acornitum/hemlock/stopwatch-point-3.kicad_pcb

## KiCad design stopwatch-point-3.kicad_pcb (2026-10-15)

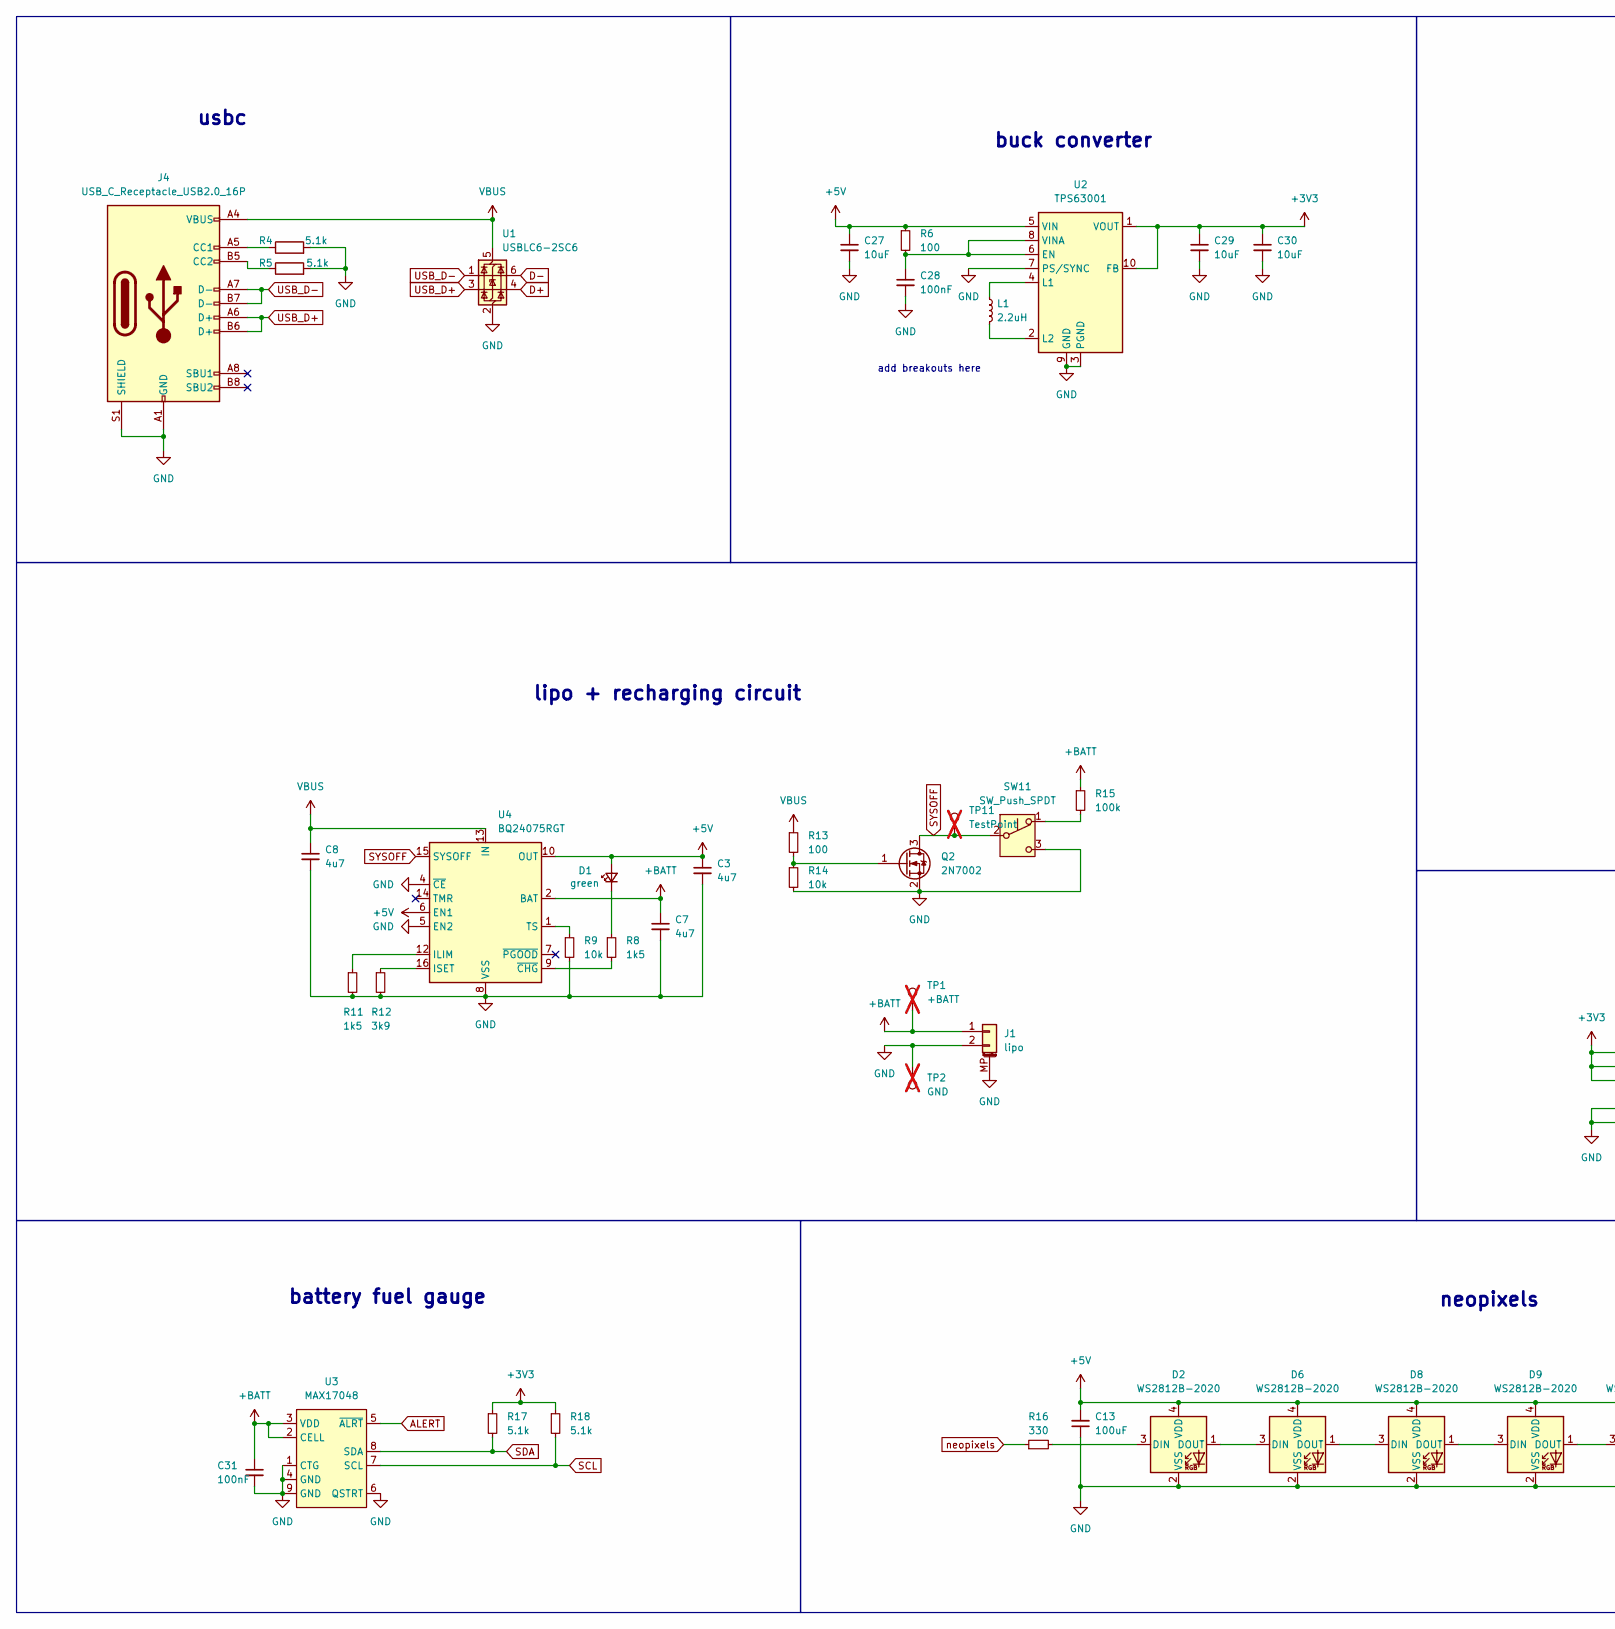
[picture p1: schematic stopwatch-point-3.kicad_sch, stopwatch!!, part in row 1, column 1]

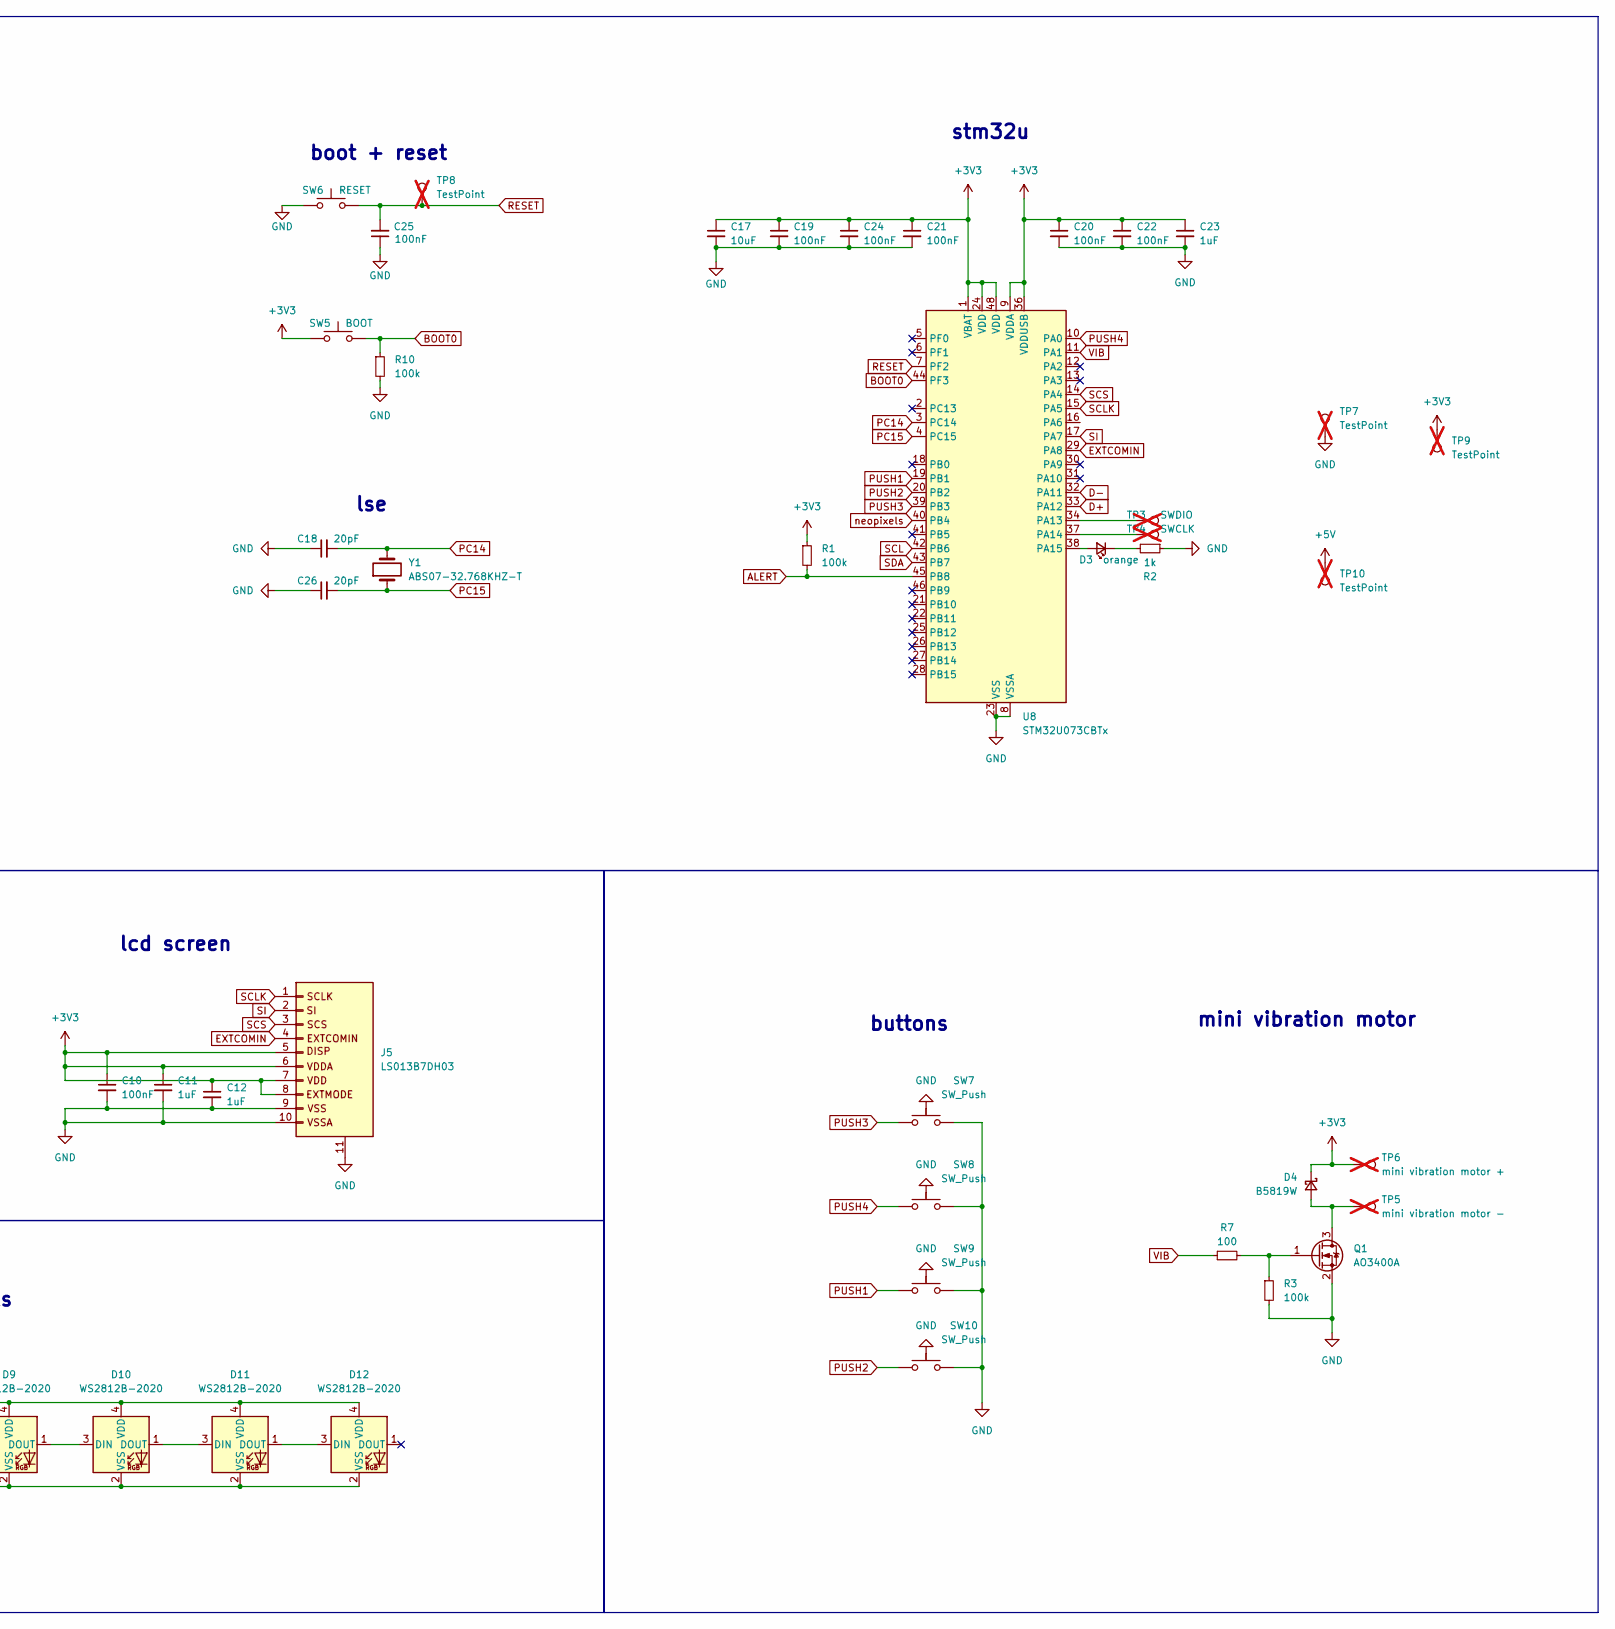
[picture p2: schematic stopwatch-point-3.kicad_sch, stopwatch!!, part in row 1, column 2]

Parts:
C3, C7, C8: 4u7; C_0402_1005Metric; LCSC C368809
C10, C19, C20, C21, C22, C24, C25, C28, C31: 100nF; C_0402_1005Metric; LCSC C60474
C11, C12, C23: 1uF; C_0402_1005Metric; LCSC C29266
C13: 100uF; C_0805_2012Metric; LCSC C141660
C17, C27, C29, C30: 10uF; C_0402_1005Metric; LCSC C15525
C18, C26: 20pF; C_0402_1005Metric; LCSC C5137579
D1: green; LED_0402_1005Metric; LCSC C74338
D2, D6, D8, D9, D10, D11, D12: WS2812B-2020; LED_WS2812B-2020_PLCC4_2.0x2.0mm; LCSC C52917434
D3: orange; LED_0402_1005Metric; LCSC C28310436
D4: B5819W; D_SOD-123; LCSC C5345968
J1: lipo; JST_PH_S2B-PH-SM4-TB_1x02-1MP_P2.00mm_Horizontal; LCSC C295747
J4: USB_C_Receptacle_USB2.0_16P; USB_C_Receptacle_GCT_USB4105-xx-A_16P_TopMnt_Horizontal; LCSC C393939
J5: LS013B7DH03; AYF531035_LS013B7DH03; LCSC C425133
L1: 2.2uH; L_0805_2012Metric; LCSC C42455275
Q1: AO3400A; SOT-23; LCSC C347475
Q2: 2N7002; SOT-23; LCSC C8545
R1, R3, R10, R15: 100k; R_0402_1005Metric; LCSC C106232
R2: 1k; R_0402_1005Metric; LCSC C106235
R4, R5, R17, R18: 5.1k; R_0402_1005Metric; LCSC C104375
R6, R7, R13: 100; R_0402_1005Metric; LCSC C106232
R8, R11: 1k5; R_0402_1005Metric; LCSC C2933074
R9, R14: 10k; R_0402_1005Metric; LCSC C60490
R12: 3k9; R_0402_1005Metric; LCSC C2909346
R16: 330; R_0402_1005Metric; LCSC C2930002
SW5: BOOT; SW_Push_SPST_NO_Alps_SKRK; LCSC C720477
SW6: RESET; SW_Push_SPST_NO_Alps_SKRK; LCSC C720477
SW7, SW8, SW9, SW10: SW_Push; SW_Push_1P1T-MP_NO_Horizontal_Alps_SKRTLAE010; LCSC C110293
SW11: SW_Push_SPDT; SW_SPDT_PCM12; LCSC C2681570
TP1: +BATT; TestPoint_Pad_D2.0mm; not fitted
TP2: GND; TestPoint_Pad_2.0x2.0mm; not fitted
TP3: SWDIO; TestPoint_Pad_D1.0mm; not fitted
TP4: SWCLK; TestPoint_Pad_D1.0mm; not fitted
TP5: mini vibration motor -; TestPoint_Pad_2.0x2.0mm; not fitted
TP6: mini vibration motor +; TestPoint_Pad_D2.0mm; not fitted
TP7: TestPoint; TestPoint_Pad_1.0x1.0mm; not fitted
TP8, TP9: TestPoint; TestPoint_Pad_D1.0mm; not fitted
TP10, TP11: TestPoint; TestPoint_Pad_D1.5mm; not fitted
U1: USBLC6-2SC6; SOT-23-6; LCSC C7519
U2: TPS63001; Texas_DRC0010J_ThermalVias; LCSC C28060
U3: MAX17048; DFN-8-1EP_2x2mm_P0.5mm_EP0.9x1.5mm; LCSC C2682616
U4: BQ24075RGT; VQFN-16-1EP_3x3mm_P0.5mm_EP1.6x1.6mm; LCSC BQ24075RGTR
U8: STM32U073CBTx; LQFP-48_7x7mm_P0.5mm; LCSC C27035627
Y1: ABS07-32.768KHZ-T; Crystal_SMD_2012-2Pin_2.0x1.2mm; LCSC C130253

Connections:
+3V3: C10.1, C11.1, C12.1, C17.1, C19.1, C20.1, C21.1, C22.1, C23.1, C24.1, C29.1, C30.1, D4.1 (K), J5.5 (DISP), J5.6 (VDDA), J5.7 (VDD), J5.8 (EXTMODE), R1.1, R17.1, R18.1, SW5.1, TP6.1, TP9.1, U2.1 (VOUT), U2.10 (FB), U8.1 (VBAT), U8.9 (VDDA), U8.24 (VDD), U8.36 (VDDUSB), U8.48 (VDD)
+5V: C3.1, C13.2, C27.1, D1.2 (A), D2.4 (VDD), D6.4 (VDD), D8.4 (VDD), D9.4 (VDD), D10.4 (VDD), D11.4 (VDD), D12.4 (VDD), R6.1, TP10.1, U2.5 (VIN), U4.6 (EN1), U4.10 (OUT), U4.11 (OUT)
+BATT: C7.1, C31.1, J1.1, R15.1, TP1.1, U3.2 (CELL), U3.3 (VDD), U4.2 (BAT), U4.3 (BAT)
ALERT: R1.2, U3.5 (~ALRT), U8.45 (PB8)
BOOT0: R10.1, SW5.2, U8.44 (PF3)
D+: U1.4 (I/O2), U8.33 (PA12)
D-: U1.6 (I/O1), U8.32 (PA11)
EXTCOMIN: J5.4 (EXTCOMIN), U8.29 (PA8)
GND: C3.2, C7.2, C8.2, C10.2, C11.2, C12.2, C13.1, C17.2, C18.1, C19.2, C20.2, C21.2, C22.2, C23.2, C24.2, C25.1, C26.1, C27.2, C28.2, C29.2, C30.2, C31.2, D2.2 (VSS), D6.2 (VSS), D8.2 (VSS), D9.2 (VSS), D10.2 (VSS), D11.2 (VSS), D12.2 (VSS), J1.2, J1.MP (MountPin), J4.A1 (GND), J4.A12 (GND), J4.B1 (GND), J4.B12 (GND), J4.S1 (SHIELD), J5.9 (VSS), J5.10 (VSSA), J5.11, Q1.2 (S), Q2.2 (S), R2.1, R3.2, R4.2, R5.2, R9.2, R10.2, R11.2, R12.2, R14.2, SW6.1, SW7.2, SW7.MP, SW8.2, SW8.MP, SW9.2, SW9.MP, SW10.2, SW10.MP, SW11.3 (C), TP2.1, TP7.1, U1.2 (GND), U2.3 (PGND), U2.7 (PS/SYNC), U2.9 (GND), U2.11 (PGND), U3.1 (CTG), U3.4 (GND), U3.6 (QSTRT), U3.9 (GND), U4.4 (~CE), U4.5 (EN2), U4.8 (VSS), U4.17 (VSS), U8.8 (VSSA), U8.23 (VSS), U8.35 (VSS), U8.47 (VSS)
unnamed: D1.1 (K), R8.1
unnamed: D2.3 (DIN), R16.2
unnamed: D2.1 (DOUT), D6.3 (DIN)
unnamed: D3.2 (A), U8.38 (PA15)
unnamed: D3.1 (K), R2.2
unnamed: D4.2 (A), Q1.3 (D), TP5.1
unnamed: D6.1 (DOUT), D8.3 (DIN)
unnamed: D8.1 (DOUT), D9.3 (DIN)
unnamed: D9.1 (DOUT), D10.3 (DIN)
unnamed: D10.1 (DOUT), D11.3 (DIN)
unnamed: D11.1 (DOUT), D12.3 (DIN)
unnamed: J4.A5 (CC1), R4.1
unnamed: J4.B5 (CC2), R5.1
unnamed: Q1.1 (G), R3.1, R7.2
unnamed: Q2.1 (G), R13.2, R14.1
unnamed: R15.2, SW11.1 (A)
unnamed: C28.1, R6.2, U2.6 (EN), U2.8 (VINA)
unnamed: L1.1, U2.4 (L1)
unnamed: L1.2, U2.2 (L2)
unnamed: R11.1, U4.12 (ILIM)
unnamed: R12.1, U4.16 (ISET)
unnamed: R9.1, U4.1 (TS)
unnamed: R8.2, U4.9 (~CHG)
unnamed: TP3.1, U8.34 (PA13)
unnamed: TP4.1, U8.37 (PA14)
PC14: C18.2, U8.3 (PC14), Y1.2
PC15: C26.2, U8.4 (PC15), Y1.1
PUSH1: SW9.1, U8.19 (PB1)
PUSH2: SW10.1, U8.20 (PB2)
PUSH3: SW7.1, U8.39 (PB3)
PUSH4: SW8.1, U8.10 (PA0)
RESET: C25.2, SW6.2, TP8.1, U8.7 (PF2)
SCL: R18.2, U3.7 (SCL), U8.42 (PB6)
SCLK: J5.1 (SCLK), U8.15 (PA5)
SCS: J5.3 (SCS), U8.14 (PA4)
SDA: R17.2, U3.8 (SDA), U8.43 (PB7)
SI: J5.2 (SI), U8.17 (PA7)
SYSOFF: Q2.3 (D), SW11.2 (B), TP11.1, U4.15 (SYSOFF)
USB_D+: J4.A6 (D+), J4.B6 (D+), U1.3 (I/O2)
USB_D-: J4.A7 (D-), J4.B7 (D-), U1.1 (I/O1)
VBUS: C8.1, J4.A4 (VBUS), J4.A9 (VBUS), J4.B4 (VBUS), J4.B9 (VBUS), R13.1, U1.5 (VBUS), U4.13 (IN)
VIB: R7.1, U8.11 (PA1)
neopixels: R16.1, U8.40 (PB4)

Notes on the sheet:
battery fuel gauge
neopixels
buttons
buck converter
lipo + recharging circuit
add breakouts here
stm32u
usbc
mini vibration motor
lcd screen
boot + reset
lse

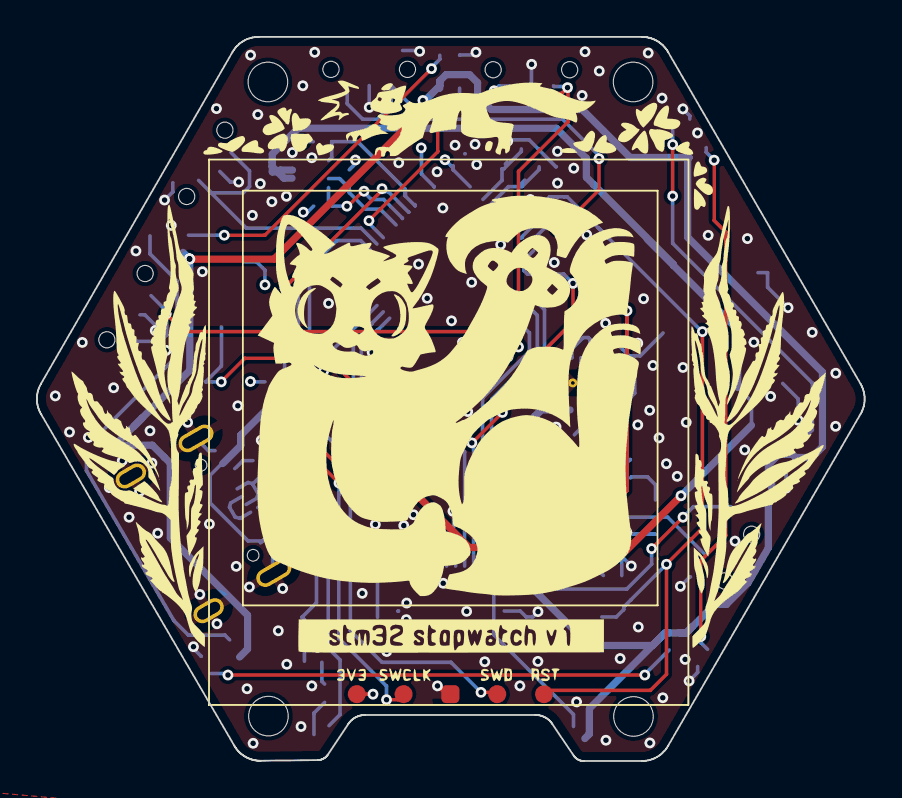
[picture p3: board stopwatch-point-3.kicad_pcb from above]

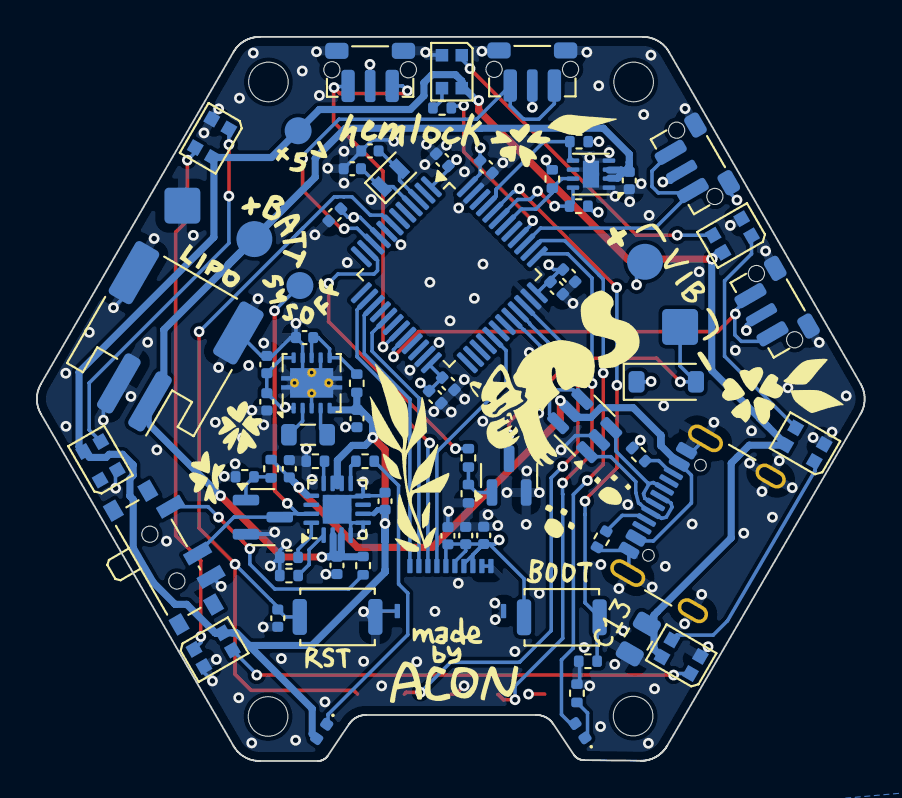
[picture p4: board stopwatch-point-3.kicad_pcb from below]

Board: 4 copper layers, 46.0 x 40.2 mm, 80 parts (75 on the bottom side), 52 nets.
