acornitum/hemlock/(commit log)

2026-10-14 pcb files
    [stopwatch-point-3.kicad_pcb, stopwatch-point-3.kicad_sch]
2026-10-14 minor fixes to pcb
    [stopwatch-point-3.kicad_pcb]
2026-10-14 add art + minor pcb changes
    [stopwatch-point-3.kicad_pcb, stopwatch-point-3.kicad_sch]
2026-10-15 pcb + art edits
    [stopwatch-point-3.kicad_pcb]
2026-10-15 minor edits
    [stopwatch-point-3.kicad_pcb, stopwatch-point-3.kicad_sch]
